ajamesdavies/kettle-call/enclosure/rear-tub.FCStd

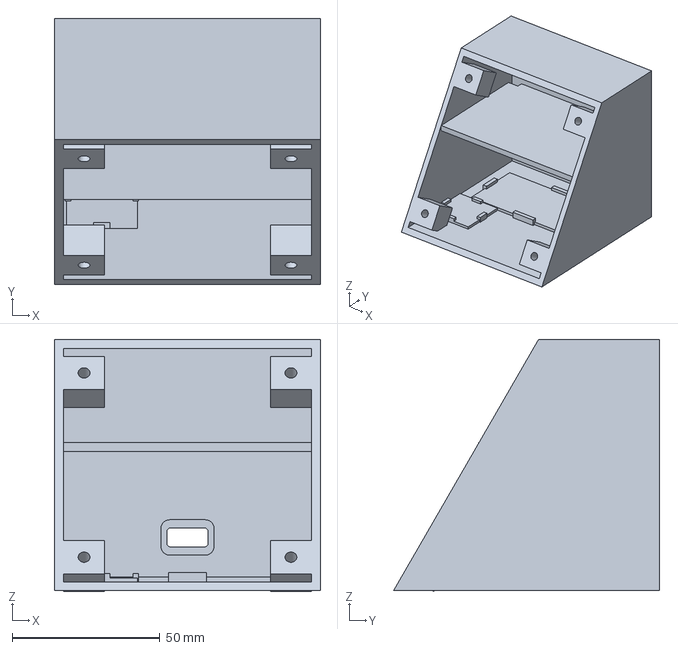
[picture p1: CAD file, 2026-11-08]
enclosure/rear-tub.FCStd
90.0 x 90.0 x 85.3 mm
