ajamesdavies/kettle-call/enclosure/faceplate.FCStd

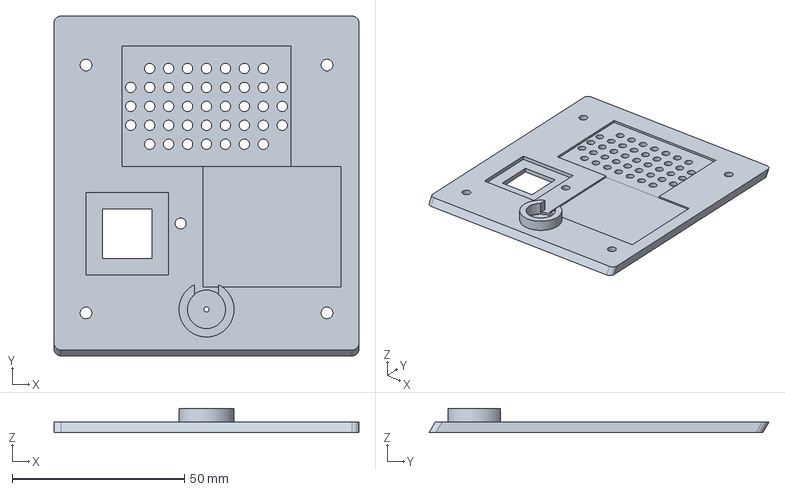
[picture p2: CAD file, 2026-11-08]
enclosure/faceplate.FCStd
88.6 x 98.7 x 7.00 mm
