ajamesdavies/kettle-call/(list of files, cad)

Other CAD files:
enclosure/faceplate.3mf
enclosure/rear-tub.3mf
