ajamesdavies/kettle-call/(commit log)

2026-11-08 Add FreeCAD enclosure models and print files
    [faceplate.3mf, faceplate.FCStd, rear-tub.3mf, rear-tub.FCStd]
2026-11-08 Add NeoPixel status driver
2026-11-08 Document wiring and setup and pin build dependencies
